Rsaliu/wifi-alarm-hardware/wifi-alarm.kicad_pcb

## KiCad design wifi-alarm.kicad_pcb (2024-09-10)

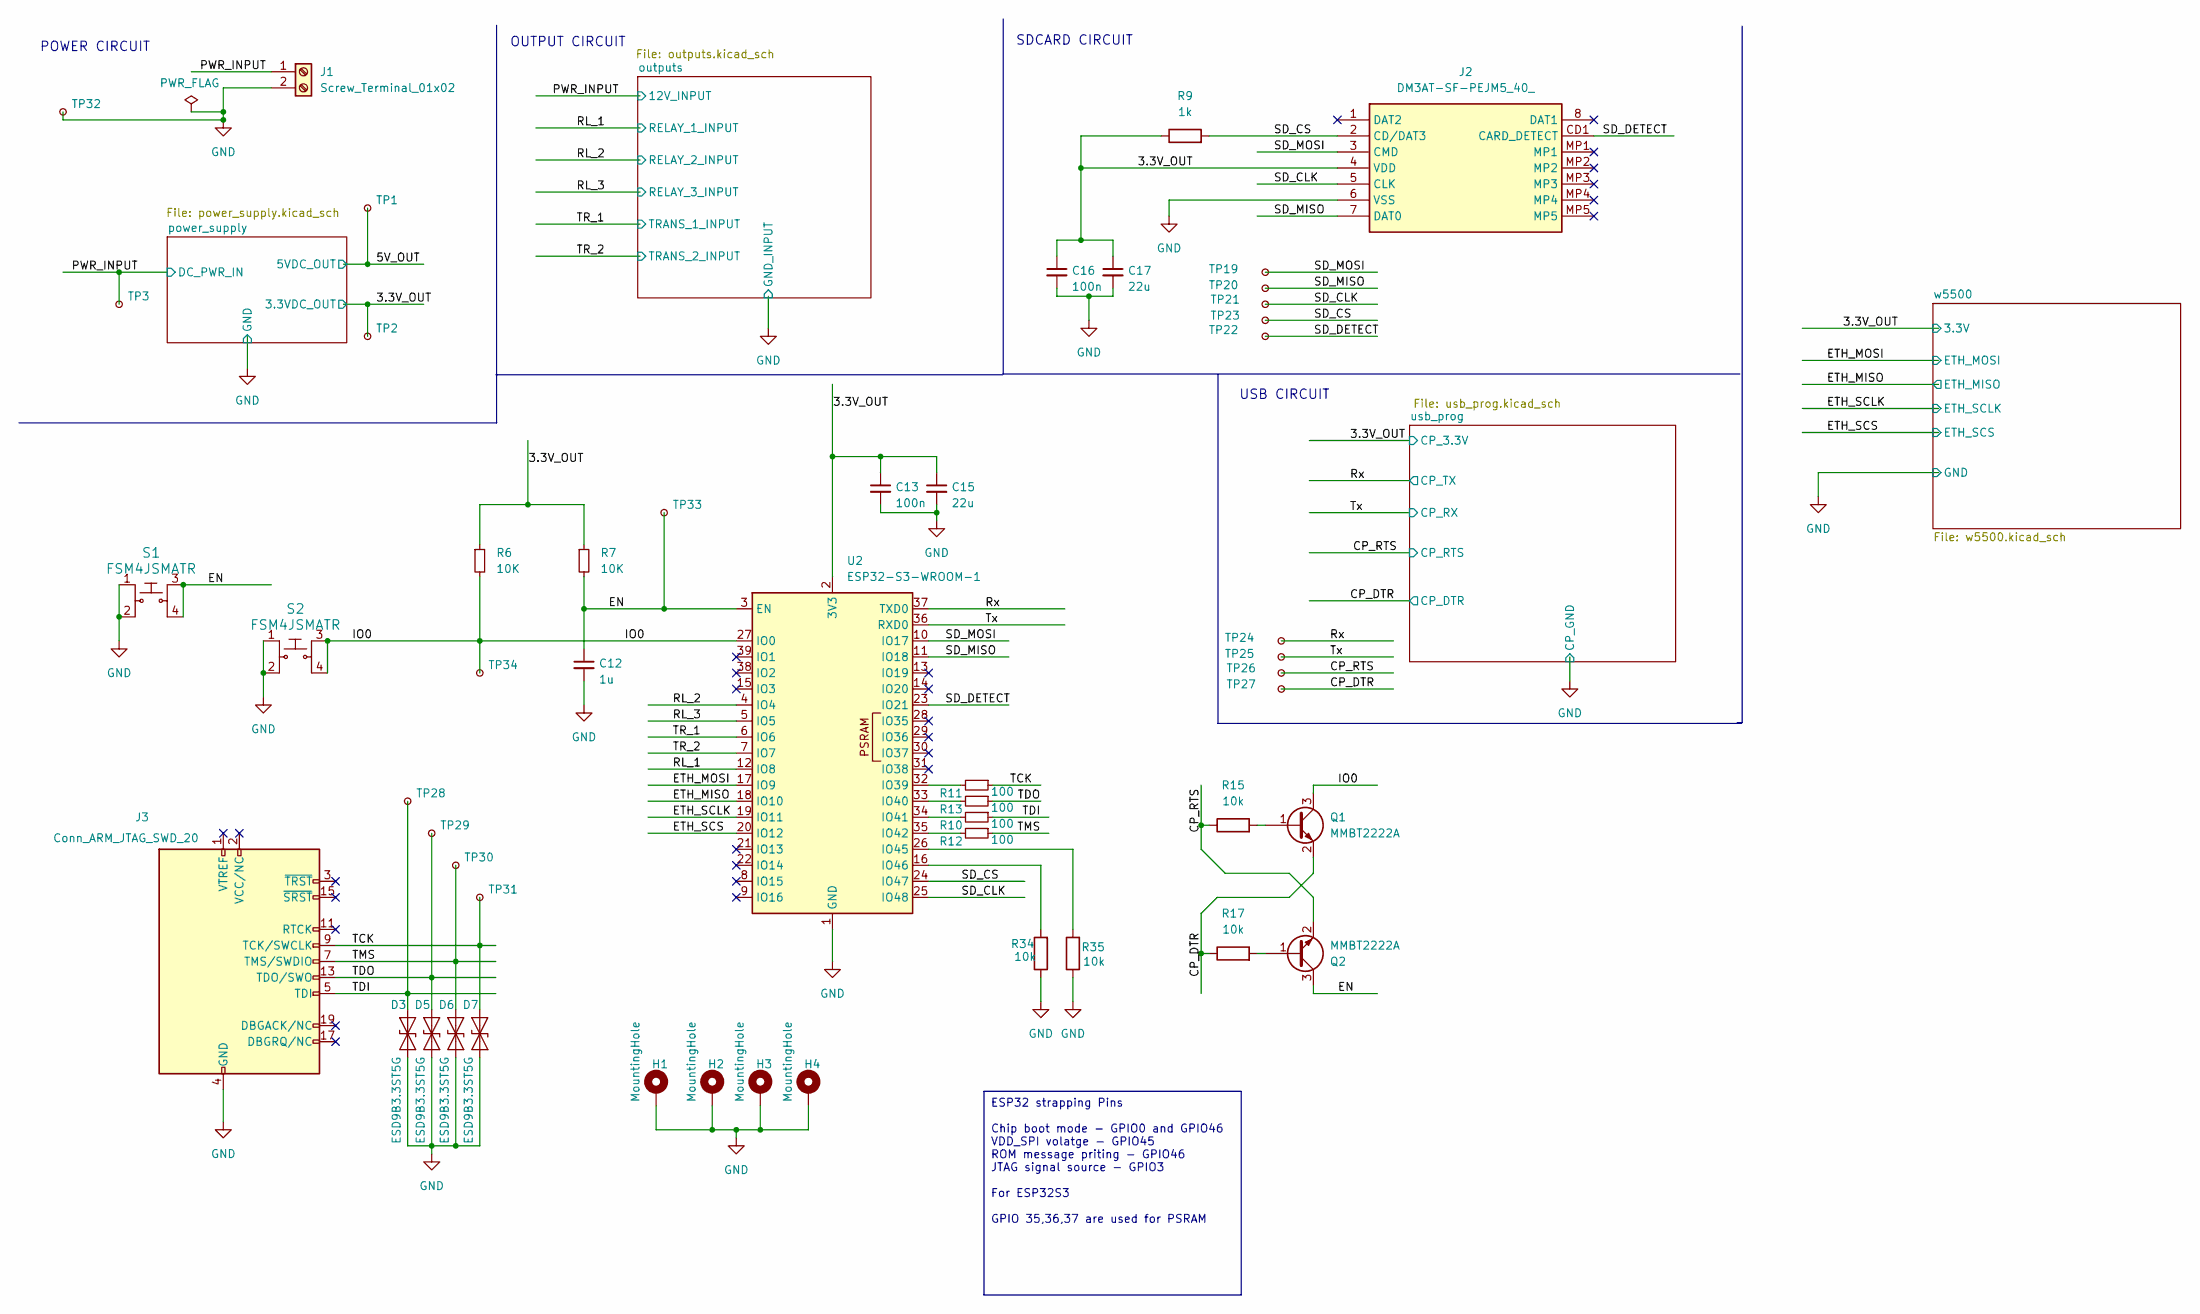
[picture p1: schematic wifi-alarm.kicad_sch]

Parts:
C12: 1u; C_0603_1608Metric_Pad1.08x0.95mm_HandSolder; part number CC0603KRX5R6BB105; JLCPCB Part # C106214
C13, C16: 100n; C_0603_1608Metric_Pad1.08x0.95mm_HandSolder; part number C0603C104K5RACAUTO; JLCPCB Part # C129621
C15, C17: 22u; C_1206_3216Metric_Pad1.33x1.80mm_HandSolder; part number HGC1206R5226M350NSPJ; JLCPCB Part # C22367834
D3, D5, D6, D7: ESD9B3.3ST5G; D_SOD-923; part number ESD9B3.3ST5G; JLCPCB Part # C3040608
H1, H2, H3, H4: MountingHole; MountingHole_2.5mm_Pad
J1: Screw_Terminal_01x02; TerminalBlock_bornier-2_P5.08mm
J2: DM3AT-SF-PEJM5_40_; DM3ATSFPEJM540; Mouser Part Number 798-DM3AT-SF-PEJM540
J3: Conn_ARM_JTAG_SWD_20; IDC-Header_2x10_P2.54mm_Vertical
Q1, Q2: MMBT2222A; SOT-23; part number MMBT2222A; JLCPCB Part # C83939
R6, R7: 10K; R_0603_1608Metric_Pad0.98x0.95mm_HandSolder; part number RC0603FR-0710KL; JLCPCB Part # C98220
R9: 1k; R_0603_1608Metric_Pad0.98x0.95mm_HandSolder; part number RC0603FR-071KL; JLCPCB Part # C22548
R10, R11, R12, R13: 100; R_0603_1608Metric_Pad0.98x0.95mm_HandSolder; part number RC0603FR-07100RL; JLCPCB Part # C105588
R15, R17, R34, R35: 10k; R_0603_1608Metric_Pad0.98x0.95mm_HandSolder; part number RC0603FR-0710KL; JLCPCB Part # C98220
S1, S2: FSM4JSMATR; Switch_Tactile_SMD_6x6mm; MPN FSM4JSMATR; JLCPCB Part # C178262
TP1, TP2, TP3, TP19, TP20, TP21, TP22, TP23, TP24, TP25, TP26, TP27, TP28, TP29, TP30, TP31, TP32, TP33, TP34: TestPoint_Pad_1.5x1.5mm
U2: ESP32-S3-WROOM-1; part number ESP32-S3-WROOM-1-N8R8; JLCPCB Part # C2913201

Connections:
/3.3V_OUT: C13.1, C15.1, C16.1, C17.1, J2.4 (VDD), R6.1, R7.1, R9.1, TP2.1, U2.2 (3V3); also elsewhere on the board
/5V_OUT: TP1.1; also elsewhere on the board
/CP_DTR: Q1.2 (E), R17.1, TP27.1; also elsewhere on the board
/CP_RTS: Q2.2 (E), R15.1, TP26.1; also elsewhere on the board
/EN: C12.1, Q2.3 (C), R7.2, S1.3, S1.4, TP33.1, U2.3 (EN)
/ETH_MISO: U2.18 (IO10); also elsewhere on the board
/ETH_MOSI: U2.17 (IO9); also elsewhere on the board
/ETH_SCLK: U2.19 (IO11); also elsewhere on the board
/ETH_SCS: U2.20 (IO12); also elsewhere on the board
/IO0: Q1.3 (C), R6.2, S2.3, S2.4, TP34.1, U2.27 (IO0)
/PWR_INPUT: J1.1, TP3.1; also elsewhere on the board
/RL_1: U2.12 (IO8); also elsewhere on the board
/RL_2: U2.4 (IO4); also elsewhere on the board
/RL_3: U2.5 (IO5); also elsewhere on the board
/Rx: TP24.1, U2.37 (TXD0); also elsewhere on the board
/SD_CLK: J2.5 (CLK), TP21.1, U2.25 (IO48)
/SD_CS: J2.2 (CD/DAT3), R9.2, TP23.1, U2.24 (IO47)
/SD_DETECT: J2.CD1 (CARD_DETECT), TP22.1, U2.23 (IO21)
/SD_MISO: J2.7 (DAT0), TP20.1, U2.11 (IO18)
/SD_MOSI: J2.3 (CMD), TP19.1, U2.10 (IO17)
/TCK: D7.2 (A2), J3.9 (TCK/SWCLK), R11.1, TP31.1
/TDI: D3.2 (A2), J3.5 (TDI), R10.1, TP28.1
/TDO: D5.2 (A2), J3.13 (TDO/SWO), R13.1, TP29.1
/TMS: D6.2 (A2), J3.7 (TMS/SWDIO), R12.1, TP30.1
/TR_1: U2.6 (IO6); also elsewhere on the board
/TR_2: U2.7 (IO7); also elsewhere on the board
/Tx: TP25.1, U2.36 (RXD0); also elsewhere on the board
GND: C12.2, C13.2, C15.2, C16.2, C17.2, D3.1 (A1), D5.1 (A1), D6.1 (A1), D7.1 (A1), H1.1, H2.1, H3.1, H4.1, J1.2, J2.6 (VSS), J3.4 (GND), J3.6 (GND), J3.8 (GND), J3.10 (GND), J3.12 (GND), J3.14 (GND), J3.16 (GND), J3.18 (GND), J3.20 (GND), R34.1, R35.1, S1.1, S1.2, S2.1, S2.2, TP32.1, U2.1 (GND), U2.40 (GND), U2.41 (GND); also elsewhere on the board
unnamed: Q1.1 (B), R15.2
unnamed: Q2.1 (B), R17.2
unnamed: R11.2, U2.32 (IO39)
unnamed: R13.2, U2.33 (IO40)
unnamed: R10.2, U2.34 (IO41)
unnamed: R12.2, U2.35 (IO42)
unnamed: R35.2, U2.26 (IO45)
unnamed: R34.2, U2.16 (IO46)

Notes on the sheet:
ESP32 strapping Pins Chip boot mode - GPIO0 and GPIO46 VDD_SPI volatge - GPIO45 ROM message priting - GPIO46 JTAG signal source - GPIO3 For ESP32S3 GPIO 35,36,37 are used for PSRAM
SDCARD CIRCUIT
USB CIRCUIT
OUTPUT CIRCUIT
POWER CIRCUIT

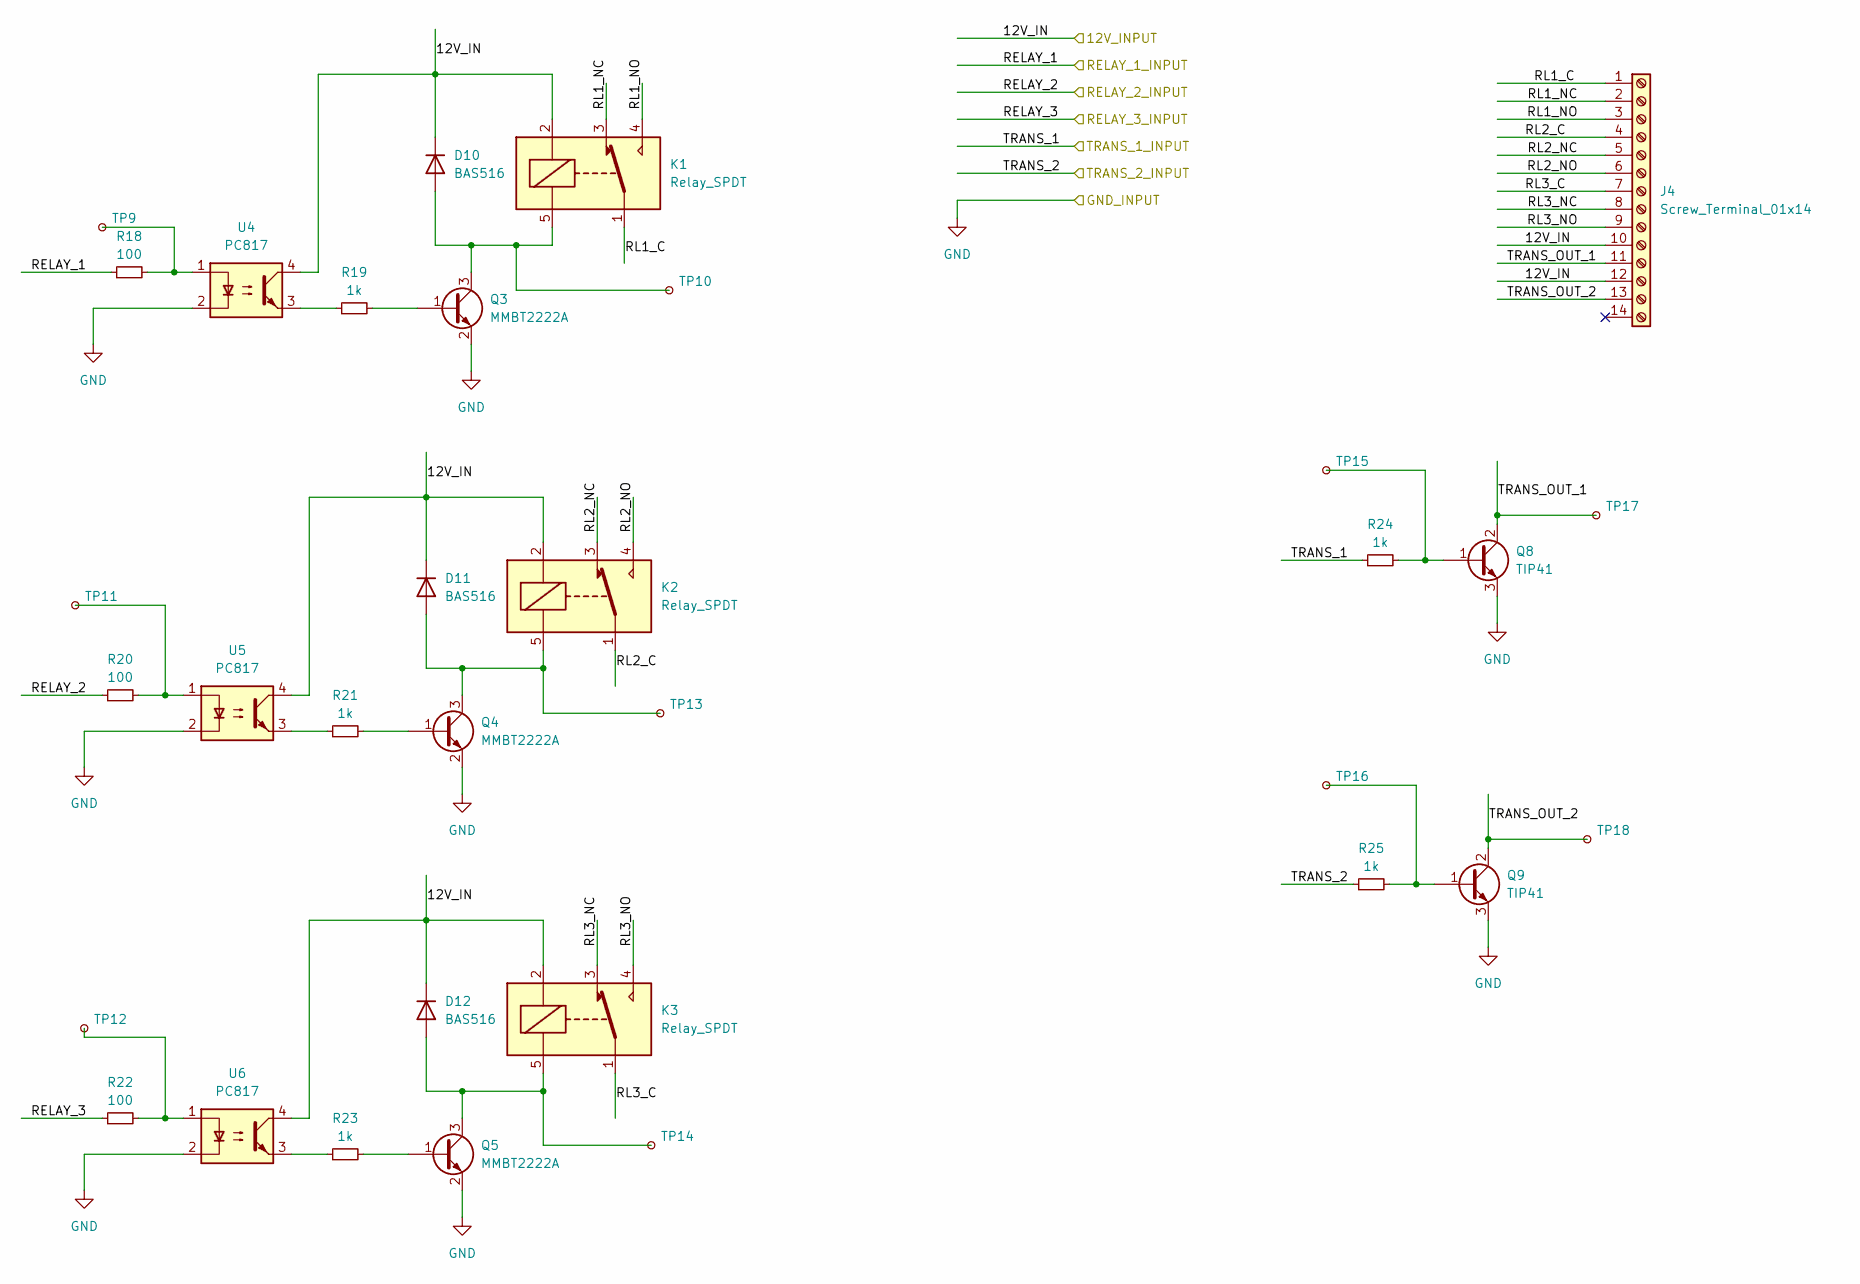
[picture p2: schematic outputs.kicad_sch]

Parts:
D10, D11, D12: BAS516; D_SOD-523; part number BAS516; JLCPCB Part # C5178954
J4: Screw_Terminal_01x14; TerminalBlock_Xinya_XY308-2.54-14P_1x14_P2.54mm_Horizontal
K1, K2, K3: Relay_SPDT; Relay_SPDT_Omron-G5LE-1; part number G5LE-1-DC12
Q3, Q4, Q5: MMBT2222A; SOT-23; part number MMBT2222A; JLCPCB Part # C83939
Q8, Q9: TIP41; TO-220-3_Vertical; part number TIP41; JLCPCB Part # C963394
R18, R20, R22: 100; R_0603_1608Metric_Pad0.98x0.95mm_HandSolder; part number RC0603FR-07100RL; JLCPCB Part # C105588
R19, R21, R23, R24, R25: 1k; R_0603_1608Metric_Pad0.98x0.95mm_HandSolder; part number RC0603FR-071KL; JLCPCB Part # C22548
TP9, TP10, TP11, TP12, TP13, TP14, TP15, TP16, TP17, TP18: TestPoint_Pad_1.5x1.5mm
U4, U5, U6: PC817; DIP-4_W7.62mm; part number PC817B; JLCPCB Part # C5451664

Connections:
/PWR_INPUT: D10.1 (K), D11.1 (K), D12.1 (K), J4.10, J4.12, K1.2, K2.2, K3.2, U4.4, U5.4, U6.4; also elsewhere on the board
/RL_1: R18.1; also elsewhere on the board
/RL_2: R20.1; also elsewhere on the board
/RL_3: R22.1; also elsewhere on the board
/TR_1: R24.1; also elsewhere on the board
/TR_2: R25.1; also elsewhere on the board
/outputs/RL1_C: J4.1, K1.1
/outputs/RL1_NC: J4.2, K1.3
/outputs/RL1_NO: J4.3, K1.4
/outputs/RL2_C: J4.4, K2.1
/outputs/RL2_NC: J4.5, K2.3
/outputs/RL2_NO: J4.6, K2.4
/outputs/RL3_C: J4.7, K3.1
/outputs/RL3_NC: J4.8, K3.3
/outputs/RL3_NO: J4.9, K3.4
/outputs/TRANS_OUT_1: J4.11, Q8.2 (C), TP17.1
/outputs/TRANS_OUT_2: J4.13, Q9.2 (C), TP18.1
GND: Q3.2 (E), Q4.2 (E), Q5.2 (E), Q8.3 (E), Q9.3 (E), U4.2, U5.2, U6.2; also elsewhere on the board
unnamed: D10.2 (A), K1.5, Q3.3 (C), TP10.1
unnamed: D11.2 (A), K2.5, Q4.3 (C), TP13.1
unnamed: D12.2 (A), K3.5, Q5.3 (C), TP14.1
unnamed: Q3.1 (B), R19.2
unnamed: Q4.1 (B), R21.2
unnamed: Q5.1 (B), R23.2
unnamed: Q8.1 (B), R24.2, TP15.1
unnamed: Q9.1 (B), R25.2, TP16.1
unnamed: R18.2, TP9.1, U4.1
unnamed: R19.1, U4.3
unnamed: R20.2, TP11.1, U5.1
unnamed: R21.1, U5.3
unnamed: R22.2, TP12.1, U6.1
unnamed: R23.1, U6.3

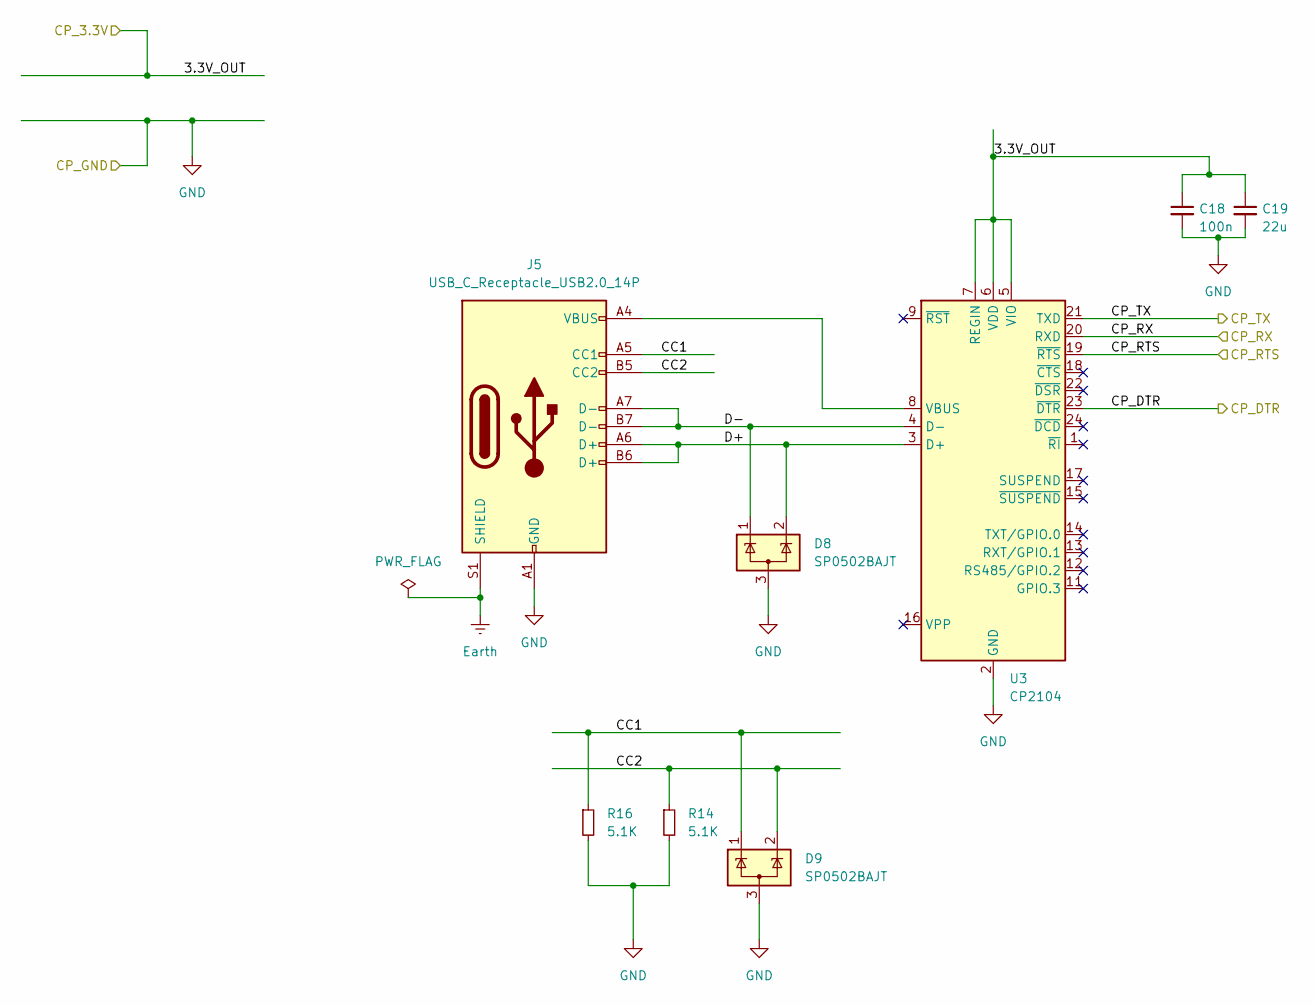
[picture p3: schematic usb_prog.kicad_sch]

Parts:
C18: 100n; C_0603_1608Metric_Pad1.08x0.95mm_HandSolder; part number C0603C104K5RACAUTO; JLCPCB Part # C129621
C19: 22u; C_1206_3216Metric_Pad1.33x1.80mm_HandSolder; part number HGC1206R5226M350NSPJ; JLCPCB Part # C22367834
D8, D9: SP0502BAJT; SOT-323_SC-70; part number SP0502BAJTG; JLCPCB Part # C207262
J5: USB_C_Receptacle_USB2.0_14P; USB_C_Receptacle_HCTL_HC-TYPE-C-16P-01A; part number TYPE C-CQ-110PWB; JLCPCB Part # C2936200
R14, R16: 5.1K; R_0603_1608Metric_Pad0.98x0.95mm_HandSolder; part number RC0603FR-075K1L; JLCPCB Part # C105580
U3: CP2104; QFN-24-1EP_4x4mm_P0.5mm_EP2.6x2.6mm; part number CP2104-F03-GM; JLCPCB Part # C47742

Connections:
/3.3V_OUT: C18.1, C19.1, U3.5 (VIO), U3.6 (VDD), U3.7 (REGIN); also elsewhere on the board
/CP_DTR: U3.23 (~DTR); also elsewhere on the board
/CP_RTS: U3.19 (~RTS); also elsewhere on the board
/Rx: U3.21 (TXD); also elsewhere on the board
/Tx: U3.20 (RXD); also elsewhere on the board
/usb_prog/CC1: D9.1 (K), J5.A5 (CC1), R16.1
/usb_prog/CC2: D9.2 (K), J5.B5 (CC2), R14.1
/usb_prog/D+: D8.2 (K), J5.A6 (D+), J5.B6 (D+), U3.3 (D+)
/usb_prog/D-: D8.1 (K), J5.A7 (D-), J5.B7 (D-), U3.4 (D-)
Earth: J5.S1 (SHIELD); also elsewhere on the board
GND: C18.2, C19.2, D8.3 (A), D9.3 (A), J5.A1 (GND), J5.A12 (GND), J5.B1 (GND), J5.B12 (GND), R14.2, R16.2, U3.2 (GND), U3.25 (GND); also elsewhere on the board
unnamed: J5.A4 (VBUS), J5.A9 (VBUS), J5.B4 (VBUS), J5.B9 (VBUS), U3.8 (VBUS)

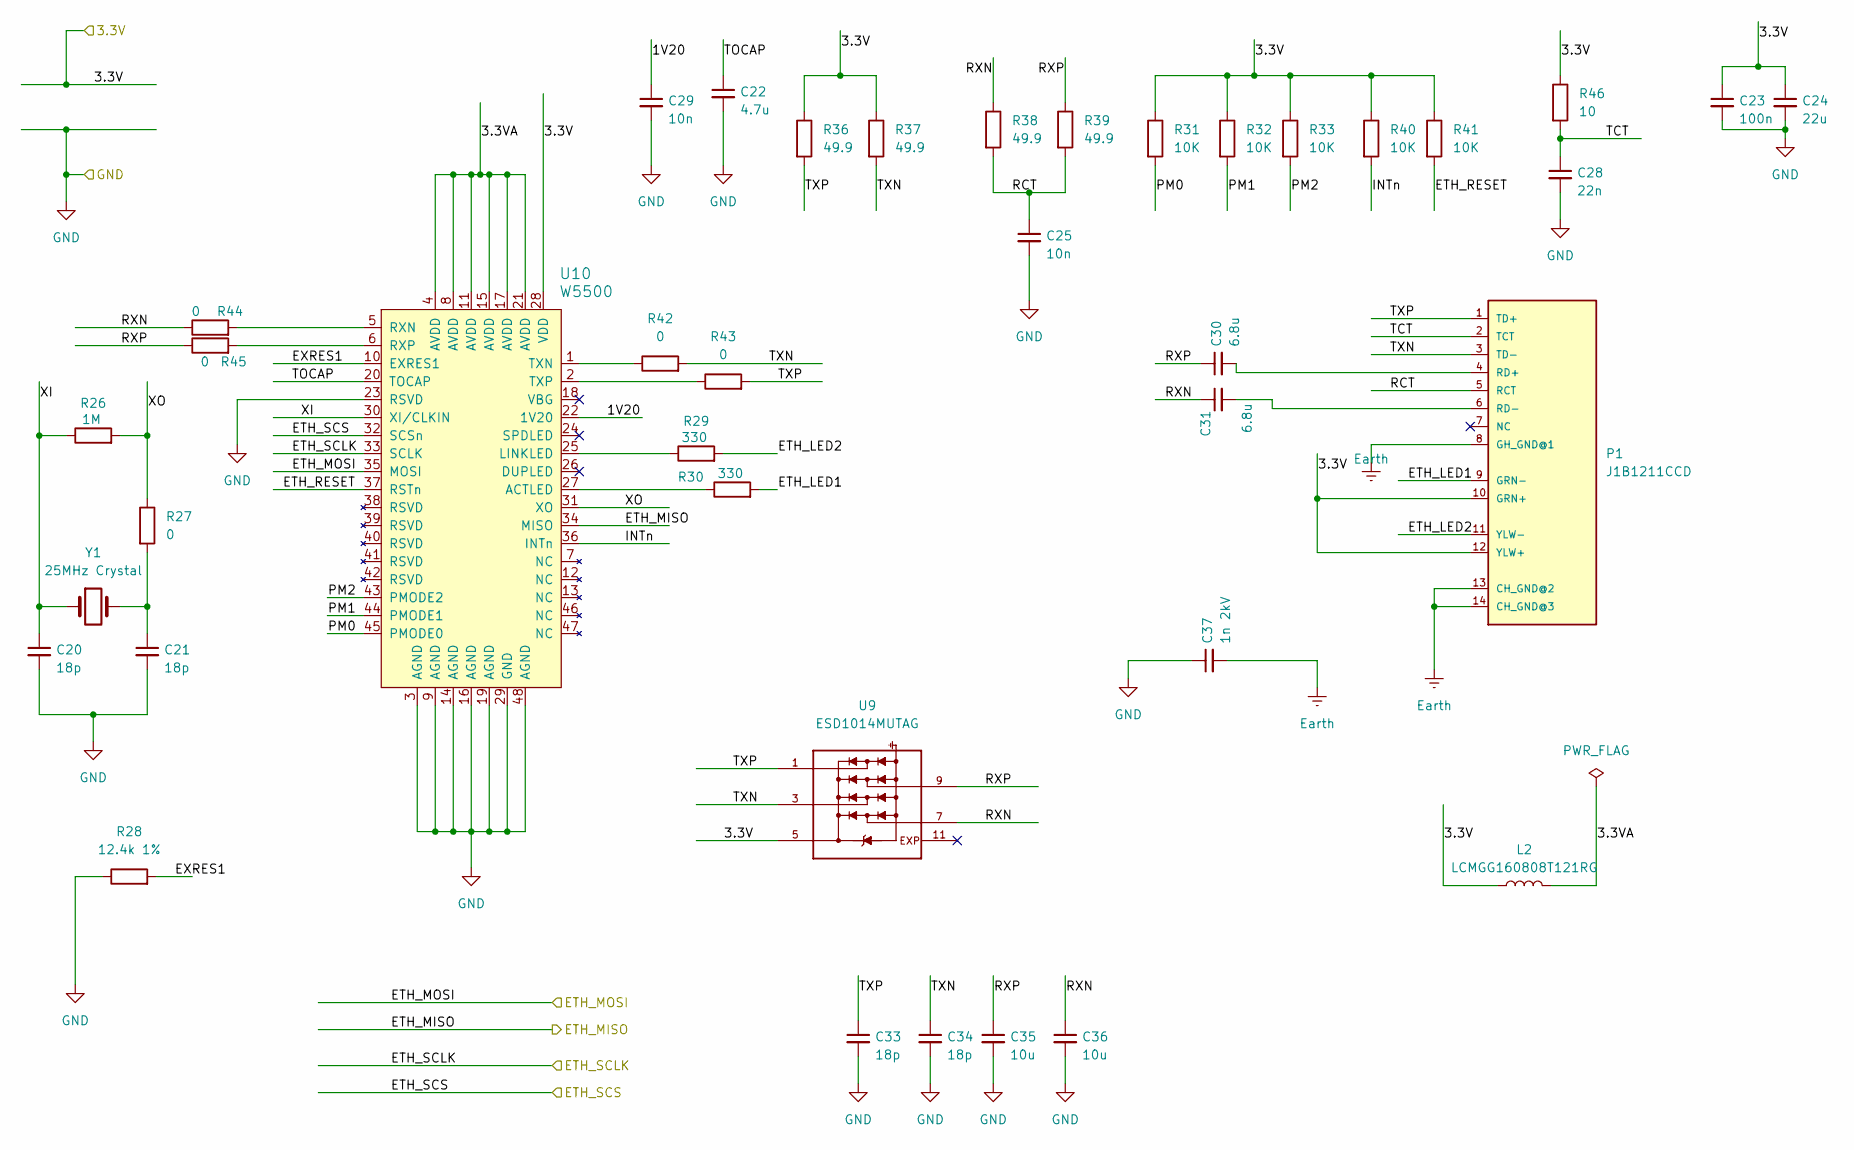
[picture p4: schematic w5500.kicad_sch]

Parts:
C20, C21, C33, C34: 18p; C_0603_1608Metric_Pad1.08x0.95mm_HandSolder; part number CC0603JRNPO8BN180; JLCPCB Part # C519389
C22: 4.7u; C_1206_3216Metric_Pad1.33x1.80mm_HandSolder; part number 0603X475K250; JLCPCB Part # C152896
C23: 100n; C_0603_1608Metric_Pad1.08x0.95mm_HandSolder; part number C0603C104K5RACAUTO; JLCPCB Part # C129621
C24: 22u; C_1206_3216Metric_Pad1.33x1.80mm_HandSolder; part number HGC1206R5226M350NSPJ; JLCPCB Part # C22367834
C25, C29: 10n; C_0603_1608Metric_Pad1.08x0.95mm_HandSolder; part number CT41G-0603-2X1-50V-0.01μF-K(N); JLCPCB Part # C136131
C28: 22n; C_1206_3216Metric_Pad1.33x1.80mm_HandSolder; part number 1206B106K500NT; JLCPCB Part # C303950
C30, C31: 6.8u; C_1206_3216Metric_Pad1.33x1.80mm_HandSolder; part number 1206B106K500NT; JLCPCB Part # C303950
C35, C36: 10u; C_1206_3216Metric_Pad1.33x1.80mm_HandSolder; part number 1206B106K500NT; JLCPCB Part # C303950
C37: 1n 2kV; C_0603_1608Metric_Pad1.08x0.95mm_HandSolder; part number CC0603KRX7R8BB102; JLCPCB Part # C519404
L2: LCMGG160808T121RG; R_0603_1608Metric_Pad0.98x0.95mm_HandSolder; part number LCMGG160808T121RG; JLCPCB Part # C6286234
P1: J1B1211CCD; part number J1B1211CCD; JLCPCB Part # C910371
R26: 1M; R_0603_1608Metric_Pad0.98x0.95mm_HandSolder; part number RC0603FR-071ML; JLCPCB Part # C105578
R27, R42, R43, R44, R45: 0; R_0603_1608Metric_Pad0.98x0.95mm_HandSolder; part number RC0603JR-070RL; JLCPCB Part # C95177
R28: 12.4k 1%; R_0603_1608Metric_Pad0.98x0.95mm_HandSolder; part number RC0603FR-0712K4L; JLCPCB Part # C137798
R29, R30: 330; R_0603_1608Metric_Pad0.98x0.95mm_HandSolder; part number RC0603FR-07330RL; JLCPCB Part # C105881
R31, R32, R33, R40, R41: 10K; R_0603_1608Metric_Pad0.98x0.95mm_HandSolder; part number RC0603FR-0710KL; JLCPCB Part # C98220
R36, R37, R38, R39: 49.9; R_0603_1608Metric_Pad0.98x0.95mm_HandSolder; part number RC0603FR-0749R9L; JLCPCB Part # C114625
R46: 10; R_0603_1608Metric_Pad0.98x0.95mm_HandSolder; part number RC0603FR-0749R9L; JLCPCB Part # C114625
U9: ESD1014MUTAG; SON50P260X260X55-11N; PARTREV 7; JLCPCB Part # C463928
U10: W5500; LQFP-48_7x7mm; MPN W5500; JLCPCB Part # C32843
Y1: 25MHz Crystal; Crystal_SMD_5032-2Pin_5.0x3.2mm_HandSoldering; part number 5032 25M 20PF 20PPM 2P; JLCPCB Part # C5380317

Connections:
/3.3V_OUT: C23.1, C24.1, L2.1, P1.10 (GRN+), P1.12 (YLW+), R31.1, R32.1, R33.1, R36.1, R37.1, R40.1, R41.1, R46.1, U9.5, U10.28 (VDD); also elsewhere on the board
/ETH_MISO: U10.34 (MISO); also elsewhere on the board
/ETH_MOSI: U10.35 (MOSI); also elsewhere on the board
/ETH_SCLK: U10.33 (SCLK); also elsewhere on the board
/ETH_SCS: U10.32 (SCSn); also elsewhere on the board
/w5500/1V20: C29.1, U10.22 (1V20)
/w5500/3.3VA: L2.2, U10.4 (AVDD), U10.8 (AVDD), U10.11 (AVDD), U10.15 (AVDD), U10.17 (AVDD), U10.21 (AVDD)
/w5500/ETH_LED1: P1.9 (GRN-), R30.2
/w5500/ETH_LED2: P1.11 (YLW-), R29.2
/w5500/ETH_RESET: R41.2, U10.37 (RSTn)
/w5500/EXRES1: R28.2, U10.10 (EXRES1)
/w5500/INTn: R40.2, U10.36 (INTn)
/w5500/PM0: R31.2, U10.45 (PMODE0)
/w5500/PM1: R32.2, U10.44 (PMODE1)
/w5500/PM2: R33.2, U10.43 (PMODE2)
/w5500/RCT: C25.1, P1.5 (RCT), R38.2, R39.2
/w5500/RXN: C31.1, C36.1, R38.1, R44.1, U9.7
/w5500/RXP: C30.1, C35.1, R39.1, R45.1, U9.9
/w5500/TCT: C28.1, P1.2 (TCT), R46.2
/w5500/TOCAP: C22.1, U10.20 (TOCAP)
/w5500/TXN: C34.1, P1.3 (TD-), R37.2, R42.2, U9.3
/w5500/TXP: C33.1, P1.1 (TD+), R36.2, R43.2, U9.1
/w5500/XI: C20.1, R26.1, U10.30 (XI/CLKIN), Y1.1
/w5500/XO: R26.2, R27.1, U10.31 (XO)
Earth: C37.2, P1.8 (GH_GND@1), P1.13 (CH_GND@2), P1.14 (CH_GND@3); also elsewhere on the board
GND: C20.2, C21.2, C22.2, C23.2, C24.2, C25.2, C28.2, C29.2, C33.2, C34.2, C35.2, C36.2, C37.1, R28.1, U10.3 (AGND), U10.9 (AGND), U10.14 (AGND), U10.16 (AGND), U10.19 (AGND), U10.23 (RSVD), U10.29 (GND), U10.48 (AGND); also elsewhere on the board
unnamed: C21.1, R27.2, Y1.2
unnamed: C30.2, P1.4 (RD+)
unnamed: C31.2, P1.6 (RD-)
unnamed: R30.1, U10.27 (ACTLED)
unnamed: R29.1, U10.25 (LINKLED)
unnamed: R44.2, U10.5 (RXN)
unnamed: R45.2, U10.6 (RXP)
unnamed: R42.1, U10.1 (TXN)
unnamed: R43.1, U10.2 (TXP)

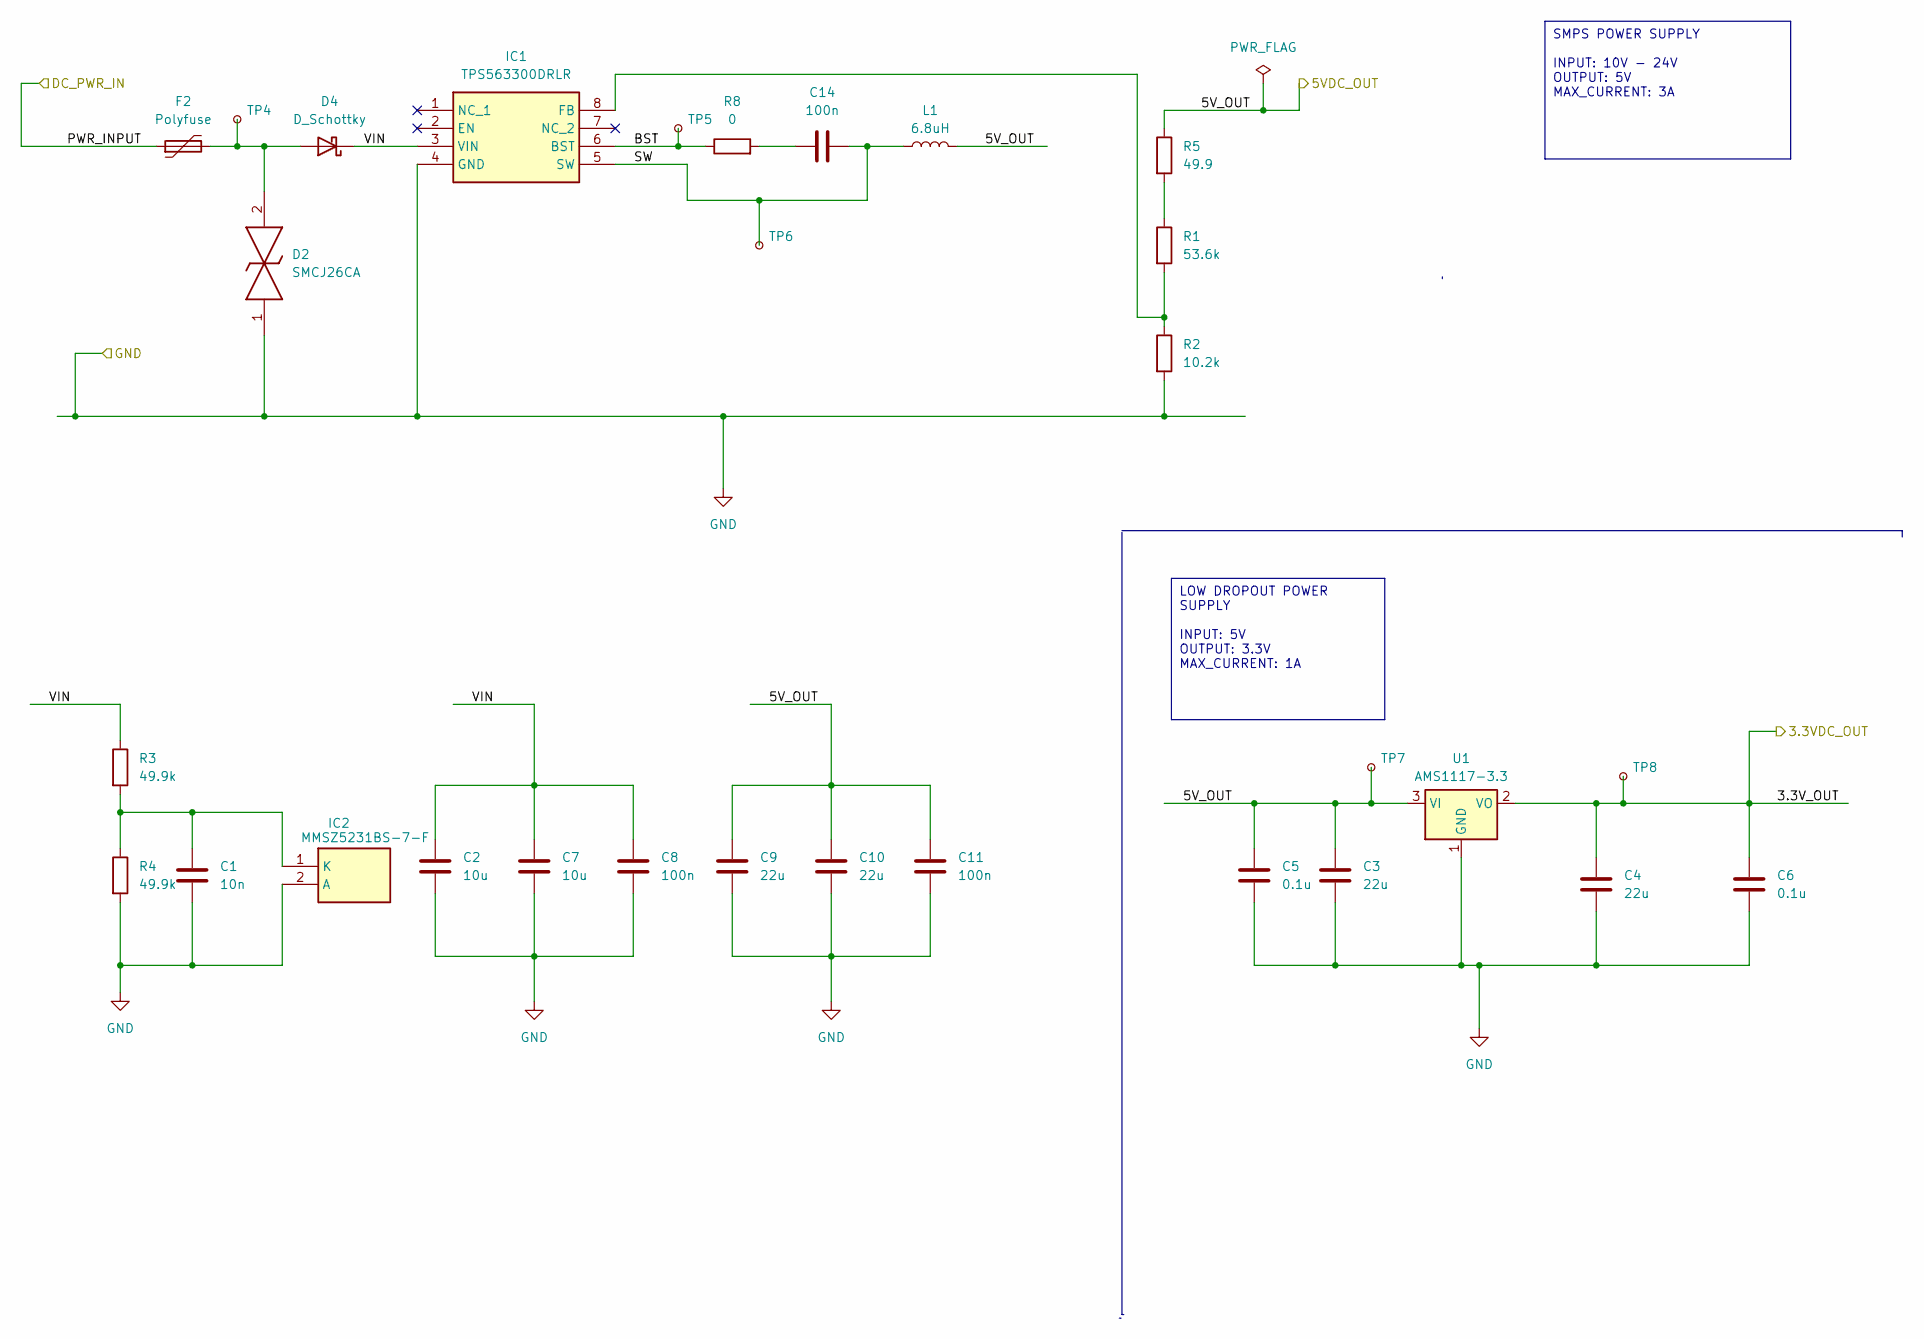
[picture p5: schematic power_supply.kicad_sch]

Parts:
C1: 10n; C_0603_1608Metric_Pad1.08x0.95mm_HandSolder; part number CT41G-0603-2X1-50V-0.01μF-K(N); JLCPCB Part # C136131
C2, C7: 10u; C_1206_3216Metric_Pad1.33x1.80mm_HandSolder; part number 1206B106K500NT; JLCPCB Part # C303950
C3, C4, C9, C10: 22u; C_1206_3216Metric_Pad1.33x1.80mm_HandSolder; part number HGC1206R5226M350NSPJ; JLCPCB Part # C22367834
C5, C6: 0.1u; C_0603_1608Metric_Pad1.08x0.95mm_HandSolder; part number CC0603KRX7R6BB104; JLCPCB Part # C519438
C8, C11, C14: 100n; C_0603_1608Metric_Pad1.08x0.95mm_HandSolder; part number C0603C104K5RACAUTO; JLCPCB Part # C129621
D2: SMCJ26CA; DIONM7959X262N; Mouser Part Number 576-SMCJ26CA
D4: D_Schottky; SOD2513X120N; part number MBR230LSFT1G; JLCPCB Part # C126673
F2: Polyfuse; FUSC3226X85N; part number MF-USHT050KX-2; JLCPCB Part # C3760720
IC1: TPS563300DRLR; TPS62932DRLR; Mouser Part Number 595-TPS563300DRLR
IC2: MMSZ5231BS-7-F; SOD2513X120N; Mouser Part Number 621-MMSZ5231BS-F
L1: 6.8uH; 74439346068; part number SPM10040T-6R8M; JLCPCB Part # C138682
R1: 53.6k; R_0603_1608Metric_Pad0.98x0.95mm_HandSolder; part number RC0603FR-0753K6L; JLCPCB Part # C137700
R2: 10.2k; R_0603_1608Metric_Pad0.98x0.95mm_HandSolder; part number RC0603FR-0710K2L; JLCPCB Part # C183219
R3, R4: 49.9k; R_0603_1608Metric_Pad0.98x0.95mm_HandSolder; part number RC0603FR-0749K9L; JLCPCB Part # C114624
R5: 49.9; R_0603_1608Metric_Pad0.98x0.95mm_HandSolder; part number RC0603FR-0749R9L; JLCPCB Part # C114625
R8: 0; R_0603_1608Metric_Pad0.98x0.95mm_HandSolder; part number RC0603JR-070RL; JLCPCB Part # C95177
TP4, TP5, TP6, TP7, TP8: TestPoint_Pad_1.5x1.5mm
U1: AMS1117-3.3; SOT-223-3_TabPin2; part number AMS1117-3.3; JLCPCB Part # C2992570

Connections:
/3.3V_OUT: C4.1, C6.1, TP8.1, U1.2 (VO); also elsewhere on the board
/5V_OUT: C3.1, C5.1, C9.1, C10.1, C11.1, L1.2, R5.1, TP7.1, U1.3 (VI); also elsewhere on the board
/PWR_INPUT: F2.1; also elsewhere on the board
/power_supply/BST: IC1.6 (BST), R8.1, TP5.1
/power_supply/SW: C14.2, IC1.5 (SW), L1.1, TP6.1
/power_supply/VIN: C2.1, C7.1, C8.1, D4.1 (K), IC1.3 (VIN), R3.1
GND: C1.2, C2.2, C3.2, C4.2, C5.2, C6.2, C7.2, C8.2, C9.2, C10.2, C11.2, D2.1, IC1.4 (GND), IC2.2 (A), R2.2, R4.2, U1.1 (GND); also elsewhere on the board
unnamed: C14.1, R8.2
unnamed: D2.2, D4.2 (A), F2.2, TP4.1
unnamed: IC1.8 (FB), R1.2, R2.1
unnamed: C1.1, IC2.1 (K), R3.2, R4.1
unnamed: R1.1, R5.2

Notes on the sheet:
LOW DROPOUT POWER SUPPLY INPUT: 5V OUTPUT: 3.3V MAX_CURRENT: 1A
SMPS POWER SUPPLY INPUT: 10V - 24V OUTPUT: 5V MAX_CURRENT: 3A

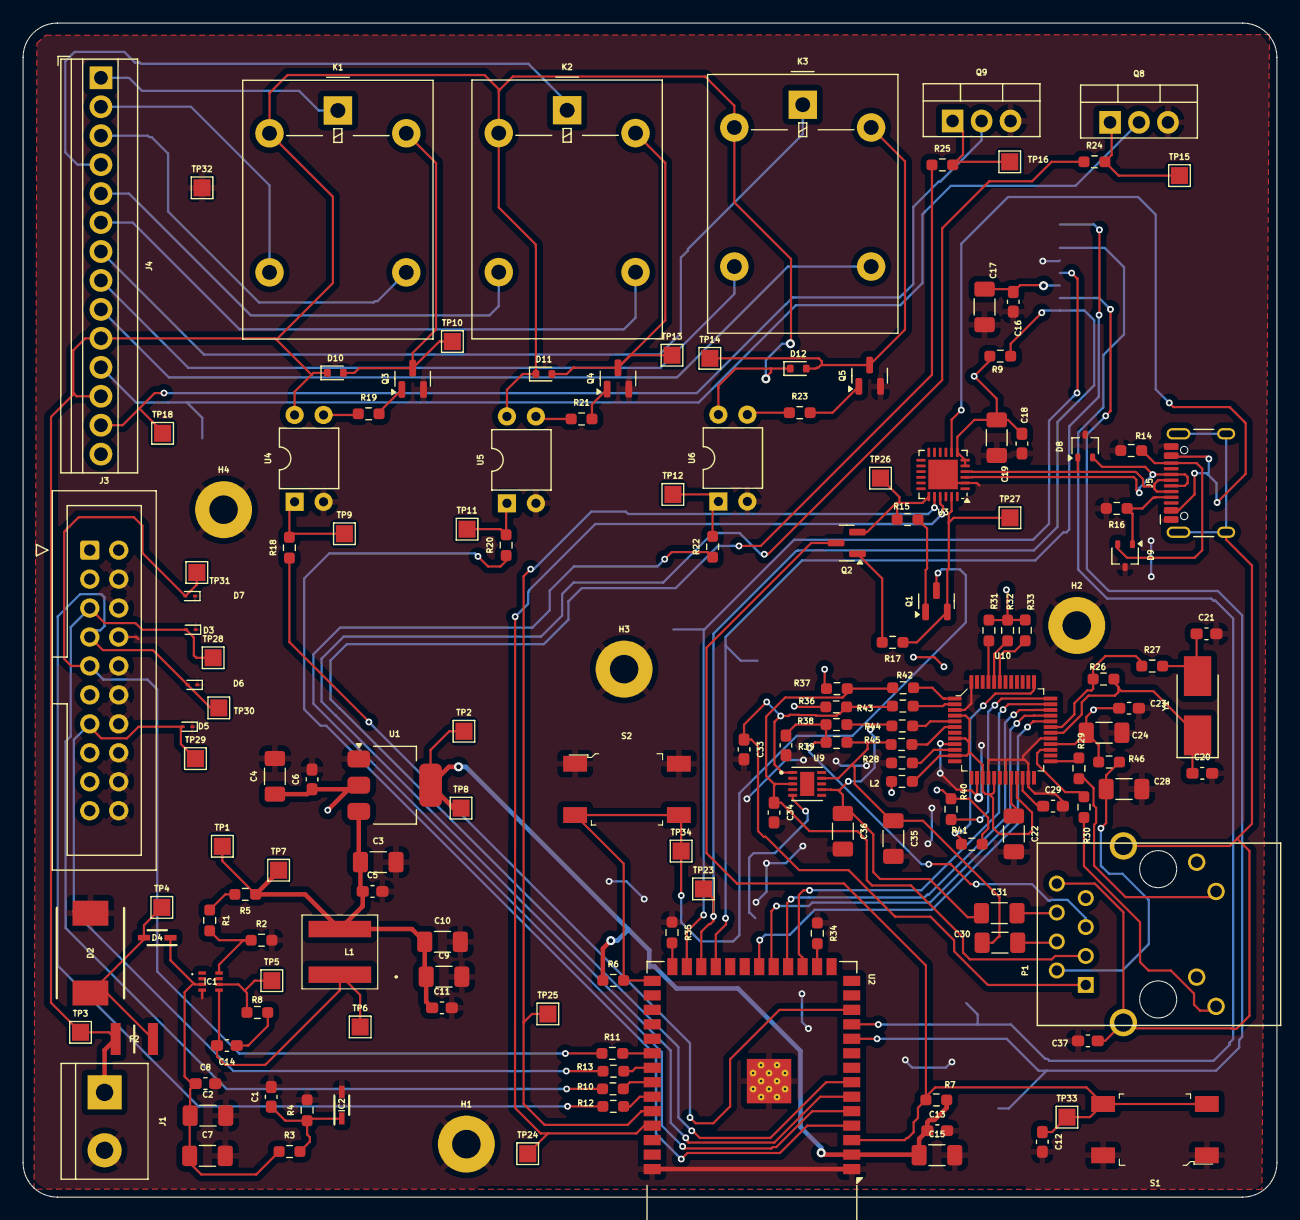
[picture p6: board wifi-alarm.kicad_pcb from above]

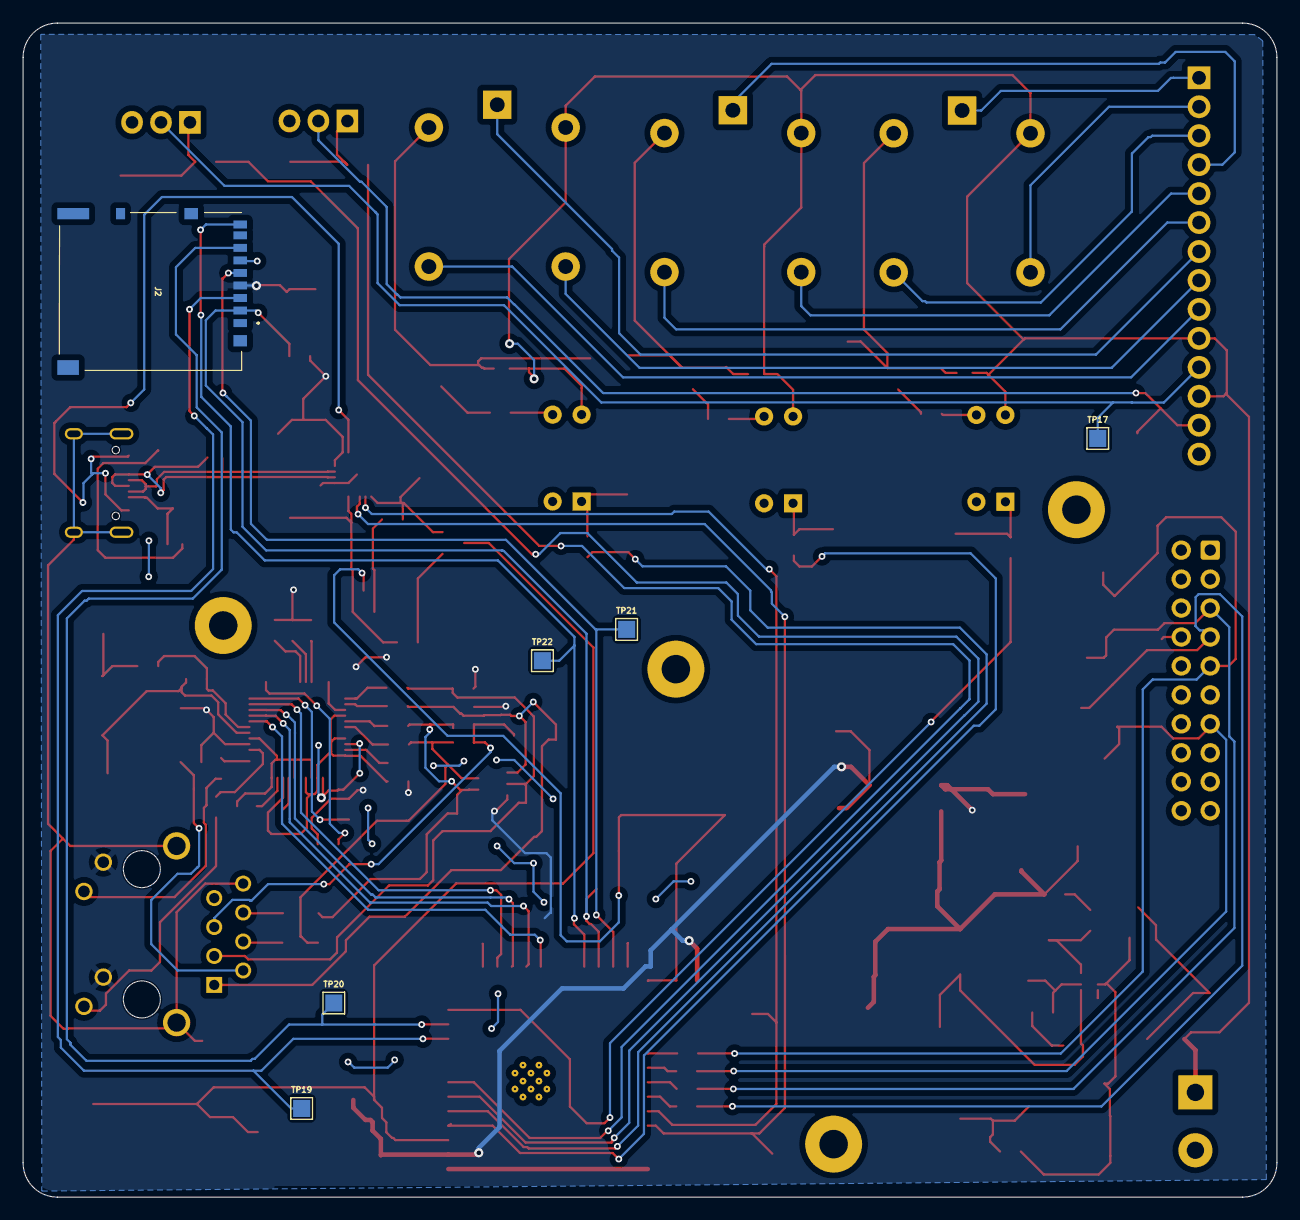
[picture p7: board wifi-alarm.kicad_pcb from below]

Board: 2 copper layers, 110.0 x 103.0 mm, 161 parts (6 on the bottom side), 103 nets.
