Rsaliu/wifi-alarm-hardware/(commit log)

2024-08-28 Initial power supply design with LM2596
    [power_supply.kicad_sch, wifi-alarm.kicad_sch]
2024-09-03 finished without LAN
    [LAN8720.kicad_sch, outputs.kicad_sch, power_supply.kicad_sch, sdcard.kicad_sch, usb_prog.kicad_sch, wifi-alarm.kicad_pcb, wifi-alarm.kicad_sch]
2024-09-04 Correct pins in schematics and add LAN8270
    [LAN8720.kicad_sch, wifi-alarm.kicad_sch]
2024-09-10 Add w5500 LAN to SPI because S3 does not have RMII, so we can't use LAN8720
    [w5500.kicad_sch, wifi-alarm.kicad_pcb, wifi-alarm.kicad_sch]
